TinkerMill/simpleAccess/hardware/BOM.pdf

PART | QTY | SUPPLIER | PART # | Retail Price
RFID Reader ID-12LA | 1 | Sparkfun | SEN-11827 | $29.95
RFID Reader Breakout Board | 1 | Sparkfun | SEN-13030 | $1.95
Relay SPDT Sealed | 1 | Sparkfun | COM-00100 | $1.95
Piezo Speaker - PC Mount 12mm | 1 | Sparkfun | COM-07950 | $1.95
Pro Micro - 5V/16MHz | 1 | Sparkfun | DEV-12640 | $19.95
Basic 16x2 Character LCD - Yellow on Blue 5V | 1 | Sparkfun | LCD-00790 | $14.95
2mm 10pin XBee Socket | 2 | Sparkfun | PRT-08272 | $2.00
Screw Terminals 2.54mm Pitch (2-Pin) | 1 | Sparkfun | PRT-10571 | $0.75
Screw Terminals 5mm Pitch (2-Pin) | 2 | Sparkfun | PRT-08432 | $1.80
Transistor - NPN (2N3904) | 1 | Sparkfun | COM-00521 | $0.50
Diode Rectifier - 1A 50V | 1 | Sparkfun | COM-08589 | $0.15
LED - SMD RGB (WS2812) | 1 | Sparkfun | COM-11821 | $0.50
Resistor 1k | 1 | Sparkfun
Capacitor 0.1uf | 1 | Sparkfun
Capacitor 100uf | 1 | Sparkfun
Female Headers | 1 | Sparkfun | PRT-00115 | $1.50
Male Headers | 1 | Sparkfun | PRT-00116 | $1.50
ProtoBoard - Wombat (PTH) | 1 | Sparkfun | PRT-08619 | $9.95
TOTAL | $89.35
