TinkerMill/simpleAccess/hardware/Clear_Plastic_Cover.dxf

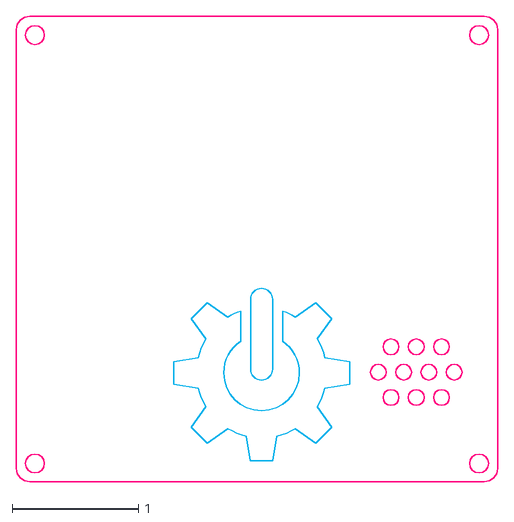
[picture p1: CAD file, 2015-04-25]
hardware/Clear_Plastic_Cover.dxf
3.81 x 3.68
