TinkerMill/simpleAccess/hardware/Inventor/RFID_Access_Node_Enclosure_v1.stl

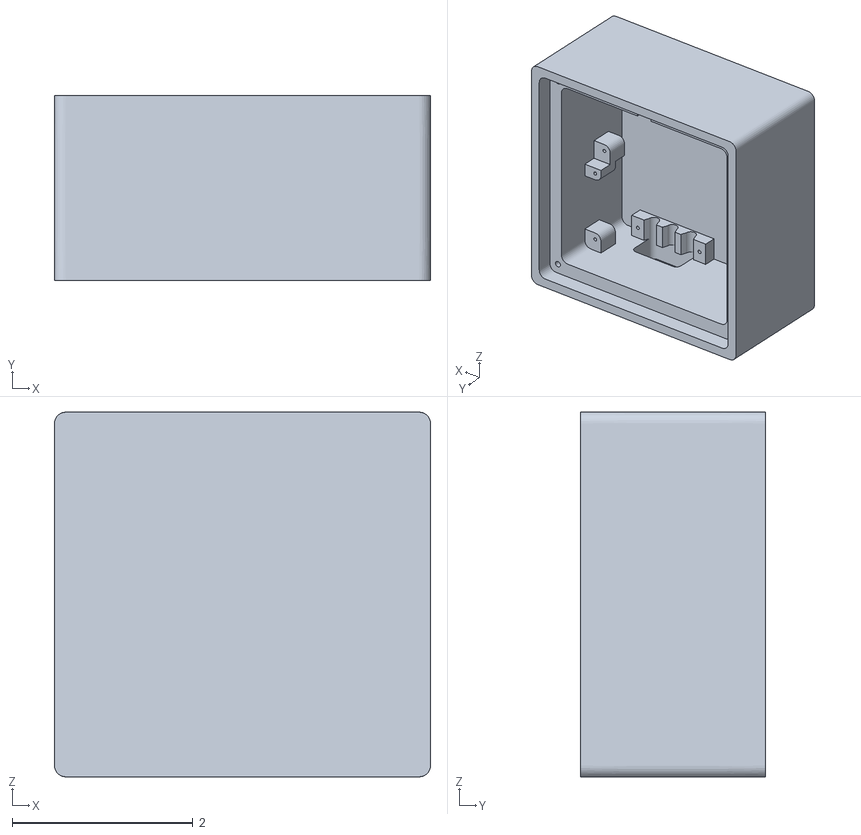
[picture p2: CAD file, 2015-04-25]
hardware/Inventor/RFID_Access_Node_Enclosure_v1.stl
4.16 x 2.05 x 4.04
