TinkerMill/simpleAccess/hardware/Inventor/Wire Clamp.stl

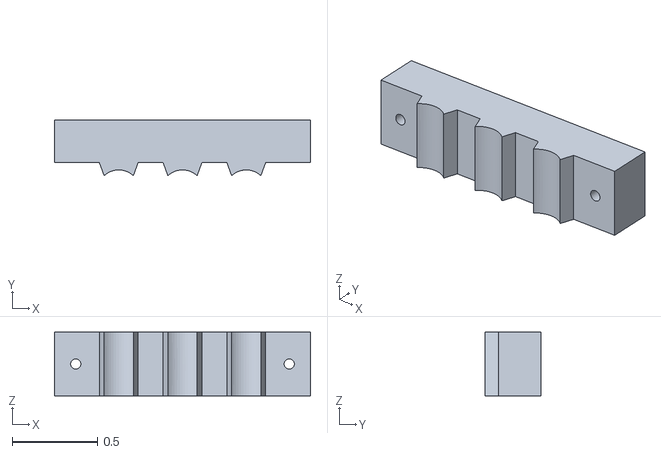
[picture p3: CAD file, 2015-04-25]
hardware/Inventor/Wire Clamp.stl
1.51 x 0.326 x 0.375
