TinkerMill/simpleAccess/(list of files, cad)

Other CAD files:
hardware/Inventor/LCD.ipt
hardware/Inventor/OldVersions/Part1.0006.ipt
hardware/Inventor/OldVersions/Part3.0004.ipt
hardware/Inventor/OldVersions/RFID_Machine_Access_Node_v1.0007.iam
hardware/Inventor/Part1.ipt
hardware/Inventor/Part3.ipt
hardware/Inventor/Part4.ipt
hardware/Inventor/RFID_Machine_Access_Node_v1.iam
hardware/Inventor/Wire Clamp.ipt
