TinkerMill/simpleAccess/hardware/PCB Layout.pdf

+

## 5V IN

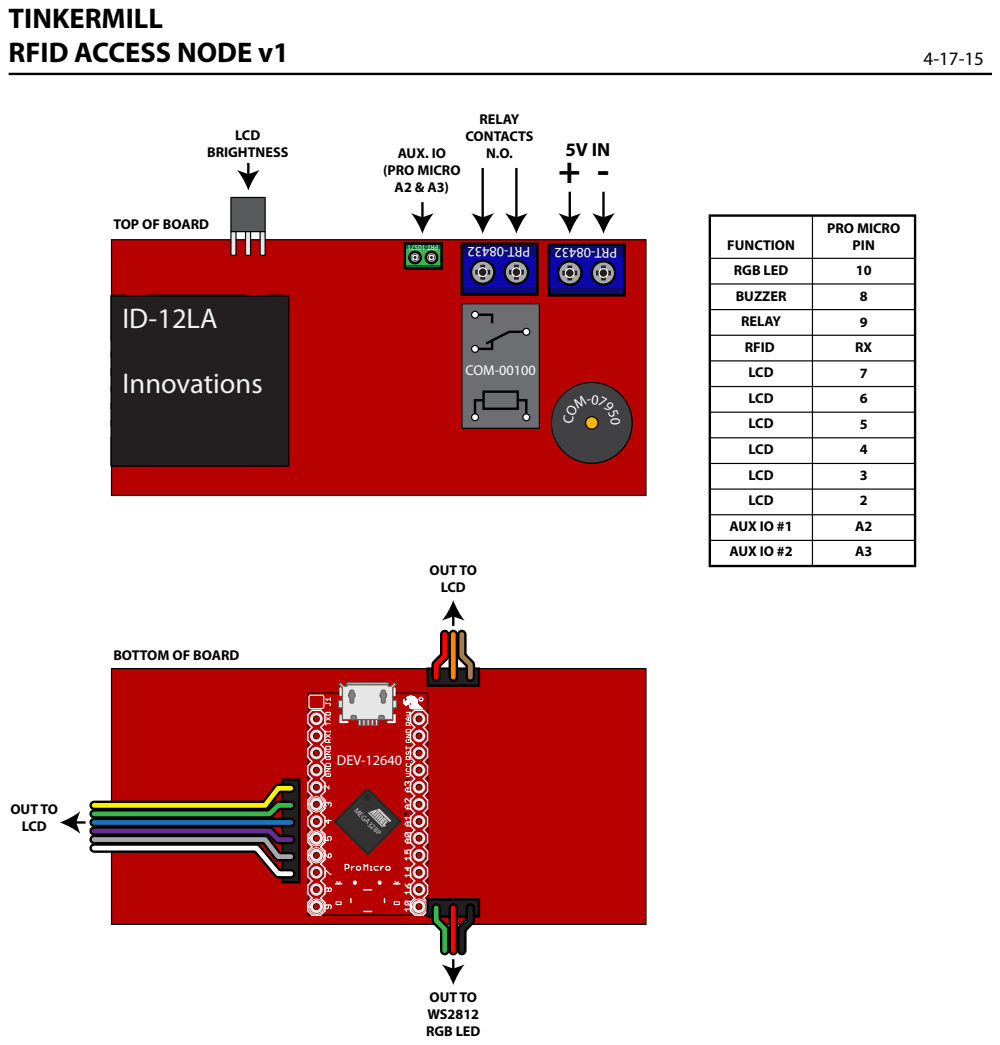
[picture p4: page 1]
COM-00100; MEGA328P; DEV-12640; Innovations; COM-07950; RELAY CONTACTS N.O.; AUX. IO (PRO MICRO A2 & A3); LCD BRIGHTNESS; OUT TO WS2812 RGB LED; OUT TO LCD; PRO MICRO; FUNCTION; PIN; RGB LED BUZZER RELAY RFID LCD LCD LCD LCD LCD LCD AUX IO #1 AUX IO #2; TINKERMILL; RFID ACCESS NODE v1

TOP OF BOARD

BOTTOM OF BOARD
