TinkerMill/simpleAccess/(threads)

Thread 6 (2015-05-08):

Access Sessions Can Stop While Cutting is Active

RonaldThomas, 2015-05-08:
The laser cutter has a hardware output that sends 5+ while a cutting job is active. It would be great if we could capture that signal and prevent access sessions from expiring while the laser is cutting.
