TinkerMill/simpleAccess/(commit log)

2015-04-20 workingish client
    [run.cfg]
2015-04-23 working windows service
    [run.cfg]
2015-04-24 working on gui move current level to status bar
2015-04-25 Added Hardware Folder
    [Clear_Plastic_Cover.dxf, LCD.ipt, Part1.0006.ipt, Part1.ipt, Part3.0004.ipt, Part3.ipt, Part4.ipt, RFID_Access_Node_Enclosure_v1.stl]
2015-04-27 New Arduino Code with Logic
    Created accessGranted and accessDenied functions for arduino.
    Added access level logic.
    Pass data to the arduino in the format "Name:Access Level", (e.g.
    "Adam:1" or "Bob:-1")
2015-04-27 logout button
2015-04-29 things are working
    [run.cfg]
2015-04-29 adduser script working, listuser script added updated docs
    [run.cfg]
2015-05-02 automatic serial port finder
    [run.cfg]
2015-05-02 fix bulk load code
    [bulk.py]
2015-05-04 Fixes #1 adds timer to status bar, moves timeout value to run.cfg
    [run.cfg]
2015-05-06 fixes issue #3 fixes issue #2
    add the ability to get username from badgecode
    update client to have minutes on status bar
    [adduser.py, client.py, server.py]
2015-05-06 added logging to client
    [run.cfg]
2015-05-06 fixing bug i put in
    [adduser.py]
2015-05-12 move database to c:\data update adduser.py to allow typing in badge number
    [run.cfg]
